WhiteFossa/LowBlow/Control Tool/EEPROM Structure.odt

Project «LowBlow» EEPROM structure

General

We have 128 bytes of EEPROM, starting from address 0.

EEPROM structure is next:

Addresses | Values
0x00 - 0x01 | Base temperature, uint16_t
0x02 | Base RPMs, uint8_t
0x03 | Steps table, 125 steps, each step is uint8_t.
0x7F

Base temperature

Base temperature stored as uint16_t, i.e. least significant byte at 0x00 and most significant byte at 0x01. Any value possible.

Base RPMs

In MCU firmware there is next values for RPMs:

Value | Meaning
0x00 | Cooler Off
0x01 | Minimal RPMs
0x100 | Maximal RPMs

We are storing Base RPMs as uint8_t, and it is meaningless to have «Cooler Off» as base RPMs. So, MCU_{BaseRPMs}=EEPROM[ 0x02 ] + 1 .

Steps

Each step is a byte, divided into two parts:

7 | 6 | 5 | 4 | 3 | 2 | 1 | 0
Delta RPMs | | | | Delta T

Delta T can not be 0, so actual temperature increase is Delta T + 1, thus [1-16]. Delta RPMs can be zero, so it [0-15].
