WhiteFossa/LowBlow/Control Tool/doxygen/latex/hierarchy.tex

\section{Class Hierarchy}
This inheritance list is sorted roughly, but not completely, alphabetically\+:\begin{DoxyCompactList}
\item \contentsline{section}{ihex\+\_\+state}{\pageref{structihex__state}}{}
\item Q\+Dialog\begin{DoxyCompactList}
\item \contentsline{section}{About\+Dialog}{\pageref{class_about_dialog}}{}
\item \contentsline{section}{New\+A\+D\+C2\+Temp\+Dialog}{\pageref{class_new_a_d_c2_temp_dialog}}{}
\end{DoxyCompactList}
\item Q\+Main\+Window\begin{DoxyCompactList}
\item \contentsline{section}{Main\+Window}{\pageref{class_main_window}}{}
\end{DoxyCompactList}
\item Q\+Object\begin{DoxyCompactList}
\item \contentsline{section}{Interfaces\+:\+:I\+Adc\+Temperature\+Convertor}{\pageref{class_interfaces_1_1_i_adc_temperature_convertor}}{}
\begin{DoxyCompactList}
\item \contentsline{section}{Adc\+Temperature\+Convertor}{\pageref{class_adc_temperature_convertor}}{}
\end{DoxyCompactList}
\item \contentsline{section}{Interfaces\+:\+:I\+E\+E\+P\+R\+O\+M\+Generator}{\pageref{class_interfaces_1_1_i_e_e_p_r_o_m_generator}}{}
\begin{DoxyCompactList}
\item \contentsline{section}{E\+E\+P\+R\+O\+M\+Generator}{\pageref{class_e_e_p_r_o_m_generator}}{}
\end{DoxyCompactList}
\item \contentsline{section}{Interfaces\+:\+:I\+Settings\+Generator}{\pageref{class_interfaces_1_1_i_settings_generator}}{}
\begin{DoxyCompactList}
\item \contentsline{section}{Settings\+Generator}{\pageref{class_settings_generator}}{}
\end{DoxyCompactList}
\item \contentsline{section}{Interfaces\+:\+:I\+Settings\+Saver\+Loader}{\pageref{class_interfaces_1_1_i_settings_saver_loader}}{}
\begin{DoxyCompactList}
\item \contentsline{section}{Settings\+Saver\+Loader}{\pageref{class_settings_saver_loader}}{}
\end{DoxyCompactList}
\item \contentsline{section}{Interfaces\+:\+:I\+Settings\+Step}{\pageref{class_interfaces_1_1_i_settings_step}}{}
\begin{DoxyCompactList}
\item \contentsline{section}{Settings\+Step}{\pageref{class_settings_step}}{}
\end{DoxyCompactList}
\end{DoxyCompactList}
\item Q\+Widget\begin{DoxyCompactList}
\item \contentsline{section}{Fossa\+:\+:Q\+Simple\+Graph\+:\+:Interfaces\+:\+:I\+Q\+Simple\+Graph}{\pageref{class_fossa_1_1_q_simple_graph_1_1_interfaces_1_1_i_q_simple_graph}}{}
\begin{DoxyCompactList}
\item \contentsline{section}{Fossa\+:\+:Q\+Simple\+Graph\+:\+:Q\+Simple\+Graph}{\pageref{class_fossa_1_1_q_simple_graph_1_1_q_simple_graph}}{}
\end{DoxyCompactList}
\end{DoxyCompactList}
\item \contentsline{section}{Fossa\+:\+:Helpers\+:\+:Xml\+Helper}{\pageref{class_fossa_1_1_helpers_1_1_xml_helper}}{}
\end{DoxyCompactList}
