WhiteFossa/LowBlow/Control Tool/doxygen/html/class_e_e_p_r_o_m_generator__coll__graph.png

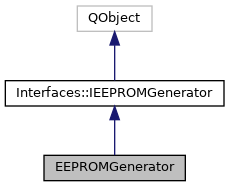
Control Tool/doxygen/html/class_e_e_p_r_o_m_generator__coll__graph.png
