WhiteFossa/LowBlow/Control Tool/doxygen/html/class_fossa_1_1_q_simple_graph_1_1_interfaces_1_1_i_q_simple_graph__coll__graph.png

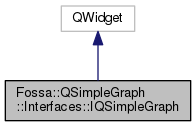
Control Tool/doxygen/html/class_fossa_1_1_q_simple_graph_1_1_interfaces_1_1_i_q_simple_graph__coll__graph.png
