WhiteFossa/LowBlow/Control Tool/doxygen/html/class_interfaces_1_1_i_adc_temperature_convertor__coll__graph.png

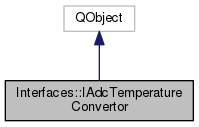
Control Tool/doxygen/html/class_interfaces_1_1_i_adc_temperature_convertor__coll__graph.png
