WhiteFossa/LowBlow/Control Tool/doxygen/html/class_interfaces_1_1_i_settings_saver_loader__coll__graph.png

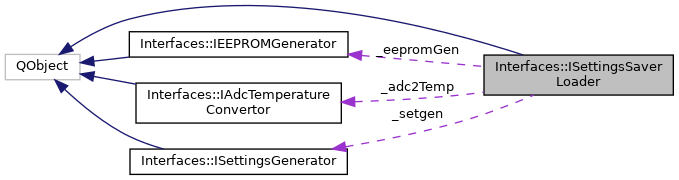
Control Tool/doxygen/html/class_interfaces_1_1_i_settings_saver_loader__coll__graph.png
