WhiteFossa/LowBlow/Control Tool/doxygen/html/dir_1ab80f2121cff7256a56ac956c93a818_dep.png

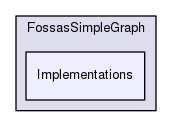
Control Tool/doxygen/html/dir_1ab80f2121cff7256a56ac956c93a818_dep.png
