WhiteFossa/LowBlow/Control Tool/doxygen/html/dir_4775ecb78e9d2f3bbd5c62ee0d07cef5_dep.png

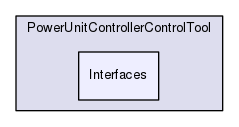
Control Tool/doxygen/html/dir_4775ecb78e9d2f3bbd5c62ee0d07cef5_dep.png
