WhiteFossa/LowBlow/Control Tool/doxygen/html/dir_f81b50375696b5edd9f09042e0553907_dep.png

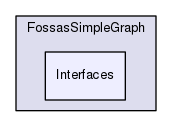
Control Tool/doxygen/html/dir_f81b50375696b5edd9f09042e0553907_dep.png
