WhiteFossa/LowBlow/Control Tool/doxygen/html/dir_f402ba3b99c05edf3d943647413842e5_dep.png

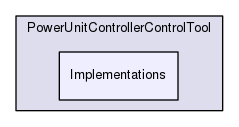
Control Tool/doxygen/html/dir_f402ba3b99c05edf3d943647413842e5_dep.png
