WhiteFossa/LowBlow/Control Tool/doxygen/html/inherit_graph_2.png

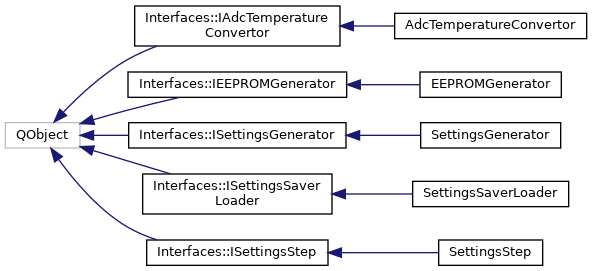
Control Tool/doxygen/html/inherit_graph_2.png
