WhiteFossa/LowBlow/Firmware/doxygen/html/hal_8c__incl.png

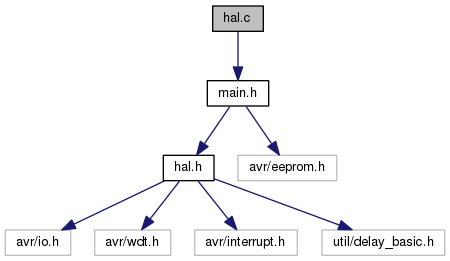
Firmware/doxygen/html/hal_8c__incl.png
