WhiteFossa/LowBlow/Firmware/doxygen/html/hal_8h__dep__incl.png

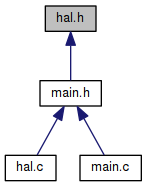
Firmware/doxygen/html/hal_8h__dep__incl.png
