WhiteFossa/LowBlow/Firmware/doxygen/html/main_8h__incl.png

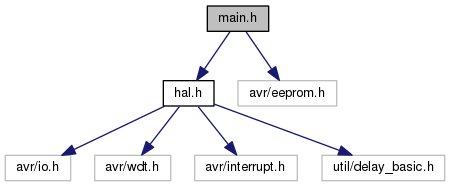
Firmware/doxygen/html/main_8h__incl.png
