WhiteFossa/LowBlow/Control Tool/doxygen/html/class_settings_step__coll__graph.png

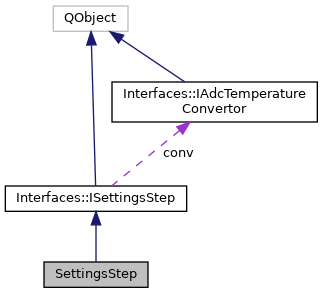
Control Tool/doxygen/html/class_settings_step__coll__graph.png
