WhiteFossa/LowBlow/Hardware/ThermalSensor_LM35.kicad_pcb

## KiCad design Hardware/ThermalSensor_LM35.kicad_pcb (2017-09-12)

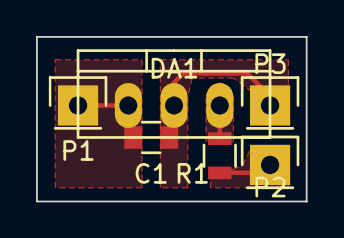
[picture p21: board ThermalSensor_LM35.kicad_pcb from above]

Board: 2 copper layers, 15.0 x 9.1 mm, 6 parts (0 on the bottom side), 4 nets.

Parts:
C1: 0.1uF; C_0805
DA1: LM35_-_TO-220; TO-220_Neutral123_Vertical
P1: VCC; Pin_Header_Straight_1x01
P2: OUT; Pin_Header_Straight_1x01
P3: GND; Pin_Header_Straight_1x01
R1: 2k; R_0805

Connections:
unnamed: C1.1, DA1.1, P1.1
unnamed: C1.2, DA1.2, P3.1
unnamed: DA1.3, R1.2
unnamed: P2.1, R1.1
