WhiteFossa/LowBlow/Hardware/PowerUnitCoolerController.kicad_pcb

## KiCad design Hardware/PowerUnitCoolerController.kicad_pcb (2017-09-12)

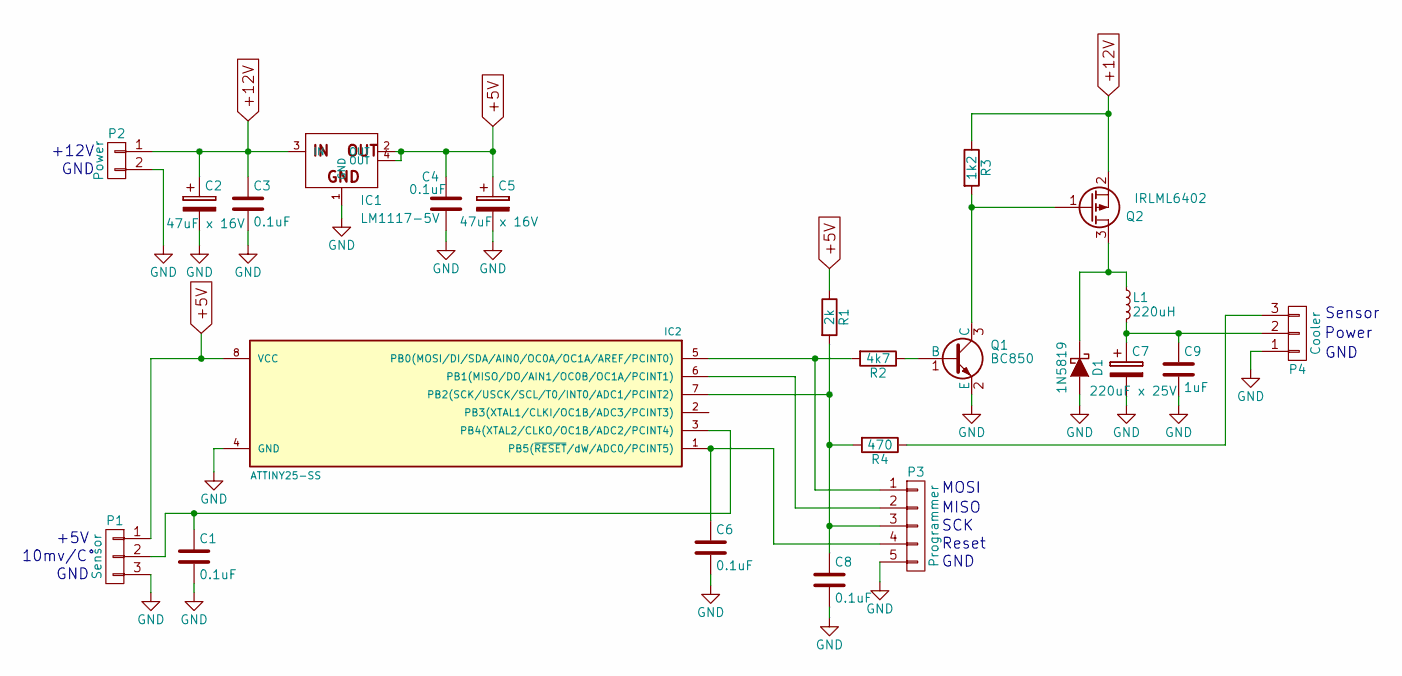
[picture p22: schematic PowerUnitCoolerController.sch, Power Unit Cooler Controller]

Parts:
C1, C3, C4, C6, C8: 0.1uF; C_0805
C2, C5: 47uF x 16V; TantalC_SizeV_EIA-7343
C7: 220uF x 25V; c_elec_8x10.5
C9: 1uF; C_0805
D1: 1N5819; MiniMELF_Handsoldering
IC1: LM1117-5V; SOT-223
IC2: ATTINY25-SS; SOIJ-8_5.3x5.3mm_Pitch1.27mm
L1: 220uH; Neosid_Inductor_SM-NE56_SMD2220
P1: Sensor; Pin_Header_Straight_1x03
P2: Power; Pin_Header_Straight_1x02
P3: Programmer; Pin_Header_Straight_1x05
P4: Cooler; Pin_Header_Straight_1x03
Q1: BC850; SOT-23
Q2: IRLML6402; SOT-23
R1: 2k; R_0805
R2: 4k7; R_0805
R3: 1k2; R_0805
R4: 470; R_0805

Connections:
+5V: C4.1, C5.1, IC1.2 (OUT), IC1.4 (OUT), IC2.8 (VCC), P1.1, R1.1
+12V: C2.1, C3.1, IC1.3 (IN), P2.1, Q2.2 (S), R3.1
GND: C1.2, C2.2, C3.2, C4.2, C5.2, C6.2, C7.2, C8.2, C9.2, D1.2 (A), IC1.1 (GND), IC2.4 (GND), P1.3, P2.2, P3.5, P4.1, Q1.2 (E)
unnamed: C1.1, IC2.3 (PB4(XTAL2/CLKO/OC1B/ADC2/PCINT4)), P1.2
unnamed: C6.1, IC2.1 (PB5(~RESET~/dW/ADC0/PCINT5)), P3.4
unnamed: C7.1, C9.1, L1.2, P4.2
unnamed: C8.1, IC2.7 (PB2(SCK/USCK/SCL/T0/INT0/ADC1/PCINT2)), P3.3, R1.2, R4.2
unnamed: D1.1 (K), L1.1, Q2.3 (D)
unnamed: IC2.5 (PB0(MOSI/DI/SDA/AIN0/OC0A/OC1A/AREF/PCI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), P3.1, R2.2
unnamed: IC2.6 (PB1(MISO/DO/AIN1/OC0B/OC1A/PCINT1)), P3.2
unnamed: P4.3, R4.1
unnamed: Q1.1 (B), R2.1
unnamed: Q1.3 (C), Q2.1 (G), R3.2

Notes on the sheet:
Sensor
Power
GND
+12V
10mv/C°
+5V
MOSI
MISO
SCK
Reset

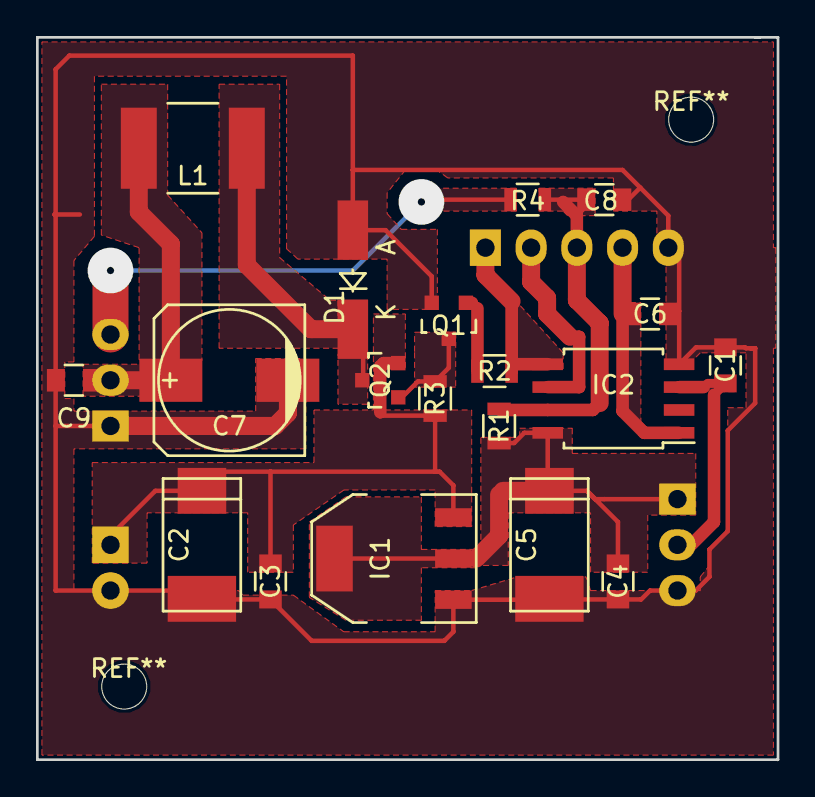
[picture p23: board PowerUnitCoolerController.kicad_pcb from above]

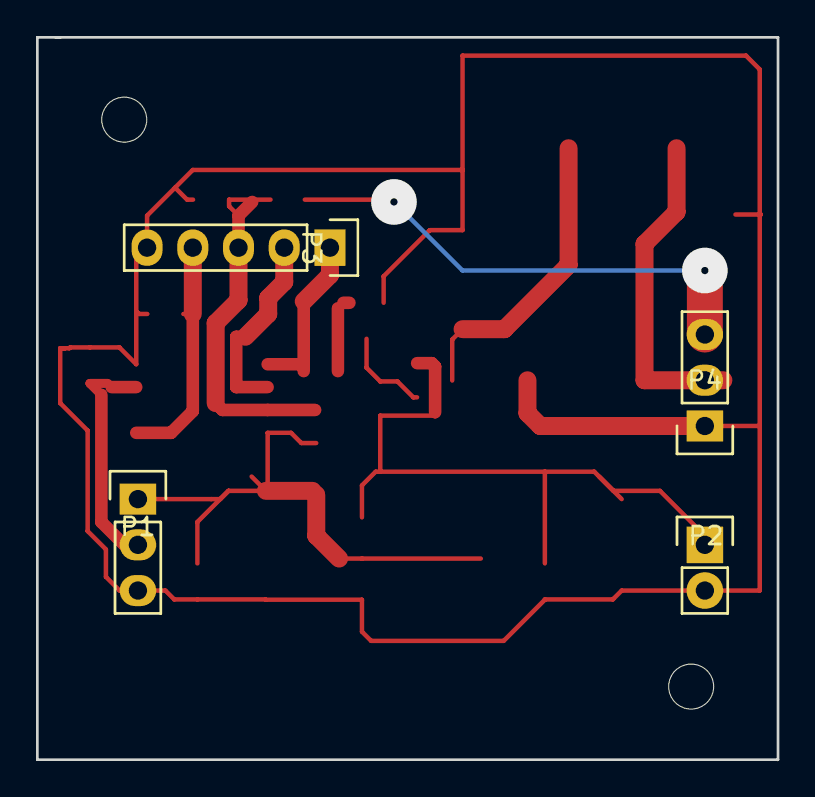
[picture p24: board PowerUnitCoolerController.kicad_pcb from below]

Board: 2 copper layers, 41.1 x 40.1 mm, 23 parts (4 on the bottom side), 13 nets.
