WhiteFossa/LowBlow/Hardware/ThermalSensor_LM335.kicad_pcb

## KiCad design Hardware/ThermalSensor_LM335.kicad_pcb (2017-09-12)

Schematic: ThermalSensor_LM335.sch, LM335 Thermal Sensor

Parts:
C1: 0.1uF; C_0805
DA1: LM335; TO-92_Molded_Narrow_Oval
P1: VCC; Pin_Header_Straight_1x01
P2: OUT; Pin_Header_Straight_1x01
P3: GND; Pin_Header_Straight_1x01
R1: 4k7; R_0805
R2: 10k; R_0805
R3: 20k; R_0805

Connections:
unnamed: C1.1, P1.1, R1.1
unnamed: C1.2, DA1.3, P3.1, R3.2
unnamed: DA1.2, R1.2, R2.1
unnamed: P2.1, R2.2, R3.1

Notes on the sheet:
6.(6) mV/°K 0°C -> 1.82V 100°C -> 2.49V

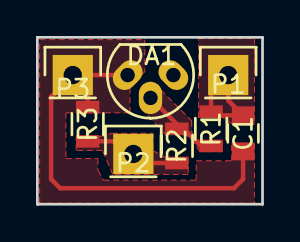
[picture p25: board ThermalSensor_LM335.kicad_pcb from above]

Board: 2 copper layers, 12.5 x 9.3 mm, 8 parts (0 on the bottom side), 4 nets.
