WhiteFossa/LowBlow/Control Tool/PowerUnitControllerControlTool/mainwindow.hpp

/*
Copyright 2017 White Fossa aka Artyom Vetrov.

This file is part of project "LowBlow" (advanced programmable cooler controller).

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
---

Part of "LowBlow" project.

Feel free to contact: whitefossa@gmail.com

Repository: https://github.com/WhiteFossa/LowBlow

If repository above is not available, try my LiveJournal: fossa-white.livejournal.com
or as last measure try to search for #WhiteFossa hashtag.
*/

#ifndef MAINWINDOW_HPP
#define MAINWINDOW_HPP

/**
	* Main window class
	*/

#include <Auxiliary.hpp>
#include <QtWidgets/QMainWindow>
#include <QtWidgets/QLabel>
#include <QtWidgets/QSpinBox>
#include <QtWidgets/QMessageBox>
#include <Interfaces/IAdcTemperatureConvertor.hpp>
#include <NewADC2TempDialog.hpp>
#include <Implementations/SettingsGenerator.hpp>
#include <Implementations/SettingsStep.hpp>
#include <Implementations/SettingsSaverLoader.hpp>
#include <FossasSimpleGraph/Implementations/QSimpleGraph.hpp>
#include <aboutdialog.h>

namespace Ui {
	class MainWindow;

	/**
	 * @brief Columns of Steps Table (ui->mw_StepsTable)
	 */
	enum STEPS_TABLE_ROWS
	{
		ADC_LEVEL = 0, /**< Row with ADC level */
		TEMPERATURE = 1, /**< Row with temperature */
		RPM_LEVEL = 2, /**< Row with RPM level */
		RPM_PERCENT = 3, /**< Row with RPM percent */
		ADC_DELTA = 4,  /**< Row with ADC level increase */
		TEMPERATURE_DELTA = 5, /**< Row with temperature increase */
		RPM_DELTA = 6, /**< Row with RPM level increase */
		RPM_DELTA_PERCENT = 7  /**< Row with RPM level increase in percents */
	};

}


class MainWindow : public QMainWindow
{
	Q_OBJECT

public:

	explicit MainWindow(QWidget *parent = 0);
	~MainWindow();

/* Public slots */
public slots:
	/**
	 * @brief mn_slot_exit
	 * Called when user want to close application.
	 */
	void MwSlotExit();

	/**
	 * @brief Called when user wants to create a new ADC->Temperature conversion settings
	 */
	void MwSlotCreateNewADC2Temp();

	/**
	 * @brief Called when user changes base temperature
	 * @param temp - new temperature in Celsius
	 */
	void MwSlotBaseTemperatureChanged(double tempC);

	/**
	 * @brief MwSlotBaseRPMChanged Called when user changes base RPM level
	 * @param RPM - new RPM value
	 */
	void MwSlotBaseRPMChanged(int RPM);

	/**
	 * @brief Called when ADC delta value of any spinbox is changed. It process change, determines what spinbox caused the change and then
	 * emits MwADCDeltaChanged(uint StepNumber, uint NewValue) with step and new value.
	 * Connect all ADC delta spinboxes in steps table to it.
	 * @param newDelta New delta value.
	 */
	void MwSlotADCDeltaChangedRaw(int newDelta);

	/**
	 * @brief As MwSlotADCDeltaChangedRaw(), but for RPM delta
	 * @param newDelta New RPM delta.
	 */
	void MwSlotRPMDeltaChangedRaw(int newDelta);

	/**
	 * @brief Called when ADC delta value of any spinbox is chaned.
	 * @param StepNumber Step number, for what change occured.
	 * @param NewDelta New ADC delta.
	 */
	void MwSlotADCDeltaChanged(uint StepNumber, uint NewDelta);

	/**
	 * @brief As MwSlotADCDeltaChanged(), but for RPM Delta change.
	 * @param StepNumber See MwSlotADCDeltaChanged().
	 * @param NewDelta New RPM delta.
	 */
	void MwSlotRPMDeltaChanged(uint StepNumber, uint NewDelta);

	/**
	 * @brief Updates UI steps table according to steps from settings generator.
	 */
	void MwSlotUpdateStepsTable();

	/**
	 * @brief Call this slot to create a new file.
	 */
	void MwSlotCreateFile();

	/**
	 * @brief Call this slot to save file.
	 */
	void MwSlotSaveFile();

	/**
	 * @brief Call it to save file under another name.
	 */
	void MwSlotSaveFileAs();

	/**
	 * @brief Call it to load existing file.
	 */
	void MwSlotLoadFile();

	/**
	 * @brief Marks current file as modified.
	 */
	void MwSlotMarkAsModified();

	/**
	 * @brief Call it to export current settings to EEPROM.
	 */
	void MwSlotExportToEEPROM();

	/**
	 * @brief Called when user wants to see about information.
	 */
	void MwSlotShowAboutDialog();


/* Signals */
signals:
	/**
	 * @brief Emit it when temperature to ADC convertor initialized with the new instance of ADC to Temperature convertor.
	 */
	void MwSignalConvertorChanged();

	/**
	 * @brief MwADCDeltaChanged Emitted when ADC delta changed for cell in steps table.
	 * @param StepNumber - Step number.
	 * @param NewValue - New ADC delta value.
	 */
	void MwSignalADCDeltaChanged(uint StepNumber, uint NewDelta);

	/**
	 * @brief As MwADCDeltaChanged(), but for RPM delta.
	 * @param StepNumber See MwADCDeltaChanged().
	 * @param NewDelta See MwADCDeltaChanged().
	 */
	void MwSignalRPMDeltaChanged(uint StepNumber, uint NewDelta);

	/**
	 * @brief Emit it when steps table (UI) needs to be re-read from settings generator.
	 */
	void MwSignalUpdateStepsTable();

	/**
	 * @brief Emit this signal when settings (such as base temperature, steps and so on) are modified to mark file as modified.
	 */
	void MwSignalFileModified();

protected:
	void changeEvent(QEvent *e);

	void closeEvent(QCloseEvent *e);

private:

	/**
	 * @brief Minimal graph width
	 */
	const uint _minGraphWidth = 300;

	/**
	 * @brief Minimal graph height
	 */
	const uint _minGraphHeight = 300;

	/**
	 * @brief Graph's stretch factor
	 */
	const double _graphStretchFactor = 10;

	/**
	 * @brief Graph's horizontal size policy
	 */
	const QSizePolicy::Policy _graphHSizePolicy = QSizePolicy::Policy::MinimumExpanding;

	/**
	 * @brief Graph's vertical size policy
	 */
	const QSizePolicy::Policy _graphVSizePolicy = QSizePolicy::Policy::MinimumExpanding;

	Ui::MainWindow *ui;

	/**
	 * @brief Label with information about ADC->Temperature conversion
	 */
	QLabel *_mwConversionStatus = nullptr;

	/**
	 * @brief Label with current filename.
	 */
	QLabel *_mwFileName = nullptr;

	/**
	 * @brief List with pointers to steps table spinboxes for ADC Deltas. This is used for determining what spinbox was changed.
	 */
	QList<QSpinBox*> _ADCDeltaSpinboxes ;

	/**
	 * @brief As _ADCDetlaSpinboxes, but for RPM deltas
	 */
	QList<QSpinBox*> _RPMDeltaSpinboxes;

	/**
	 * @brief Graph to display RPMs-themperature relation
	 */
	Fossa::QSimpleGraph::QSimpleGraph* _graph = nullptr;

	/**
	 * @brief _settingsSaverLoader Settings saver/loader.
	 */
	Interfaces::ISettingsSaverLoader* _settingsSaverLoader = nullptr;

	/**
	 * @brief Call this to initialize given steps table column. Requires initialized _ADCDetlaSpinboxes and _RPMDeltaSpinboxes.
	 * @param col Column number (starting from 0)
	 */
	void InitializeStepsTableColumn(uint col);

	/**
	 * @brief Call this method to lock or unlock UI elements, related to loaded file.
	 * @param isUnlock if true, then elements will be unlocked.
	 */
	void LockUnlockInterface(bool isUnlock);

		/**
	 * @brief Updates displayed filename from _settingsSaverLoader
	 */
	void UpdateDisplayedFileName();

	/**
	 * @brief Updates information on ADC->Temperature convertor. Call it after create/open file.
	 */
	void UpdateConvertorInformation();

	/**
	 * @brief Performs initialization after file changed (i.e. created or loaded).
	 */
	void InitializeAfterFileChanged();

	/**
	 * @brief Checks if current file modified, if so - shows request to save and saves if user approves.
	 * @param action Text, representing action. For example "create new file".
	 */
	void CheckDoSaveNeeded(QString action);

	/**
	 * @brief Call this method to update base temperature (for example when user changed it). It doesn't mark file as modified.
	 * @param baseTemp Base temperature in Celsius.
	 */
	void UpdateBaseTemperature(double baseTemp);

	/**
	 * @brief As UpdateBaseTemperature(), but for base RPMs.
	 * @param RPM New base RPMs.
	 */
	void UpdateBaseRPMs(int RPM);

	/**
	 * @brief Call it to connect/disconnect user signals (such as base temperature/RPM delta changed) to slots.
	 * @param isConnect If set to true, than signals will be connected, otherwise - disconnected.
	 */
	void ConnectUISlots(bool isConnect);


};

#endif // MAINWINDOW_HPP
