WhiteFossa/LowBlow/(commit log)

2017-09-12 Moved from my local repository.
    [PowerUnitCoolerController-output.sch, PowerUnitCoolerController-tacho.sch, PowerUnitCoolerController.kicad_pcb, PowerUnitCoolerController.sch, ThermalSensor_LM335.kicad_pcb, ThermalSensor_LM335.sch, ThermalSensor_LM35.kicad_pcb, ThermalSensor_LM35.sch]
2017-09-24 Tabluation fixed; Settings saver/loader beginned.
    [AdcTemperatureConvertor.cpp, AdcTemperatureConvertor.hpp, NewADC2TempDialog.cpp, NewADC2TempDialog.hpp]
2017-10-22 Before starting to use ADC->Temperature convertor from SettingsSaverLoader.
2017-10-26 Now using ADC->Temperature convertor from settings saver/loader.
2017-10-26 Switched to settings generator from settings saver/loader.
2017-12-17 - Fixed crash on Cancel in dialog for new file creation.
    [mainwindow.cpp]
2018-01-02 Now base temperature and RPM level can be loaded from file.
2018-02-18 Refactored settings loader in ADC -> Temperature convertor.
2018-02-18 Now "modified" mark is being set almost correctly.
    [mainwindow.cpp, mainwindow.hpp]
2018-03-04 - Now marking file as modified work correctly; - Some refactoring in MainWindow.
    [mainwindow.cpp, mainwindow.hpp]
2018-08-28 Fixed bug with non-zero ADC delta in zero step.
    [SettingsGenerator.cpp, SettingsSaverLoader.cpp, mainwindow.cpp]
2018-08-28 - Now it seems that firmware is ready - Updated doxygen documentation for firmware
    [PowerUnitCoolerController.sch]
2018-08-28 Fixed bug with ADC delta
    [AdcTemperatureConvertor.cpp, AdcTemperatureConvertor.hpp, SettingsStep.cpp]
2018-08-29 Fixed SEGFAULT on settings open.
    [SettingsStep.cpp, SettingsStep.hpp]
2018-08-29 Fixed bug with incorrect base temperature in EEPROM.
    [EEPROMGenerator.cpp, EEPROMGenerator.hpp]
2018-08-29 Fixed bugs in firmware
    [main.c]
