WhiteFossa/LowBlow/(notices)

Notices in the files:
Control Tool/PowerUnitControllerControlTool/Implementations/SettingsStep.hpp:
All parts of "LowBlow" is free software: you can redistribute it and/or modify
it under the terms of the GNU General Public License as published by
the Free Software Foundation, either version 3 of the License, or
(at your option) any later version.
Firmware/hal.c:
you can redistribute it and/or modify it under the terms of the
GNU General Public License as published by the Free Software
Hardware/PowerUnitCoolerController.kicad_pcb:
Licence: GPLv3+
